nedhorning/TerrapinTracker/Images/switch.png

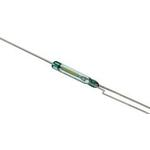
Images/switch.png
