nedhorning/TerrapinTracker/tracker/Hardware/Enclosure/enclosureComparison.jpg

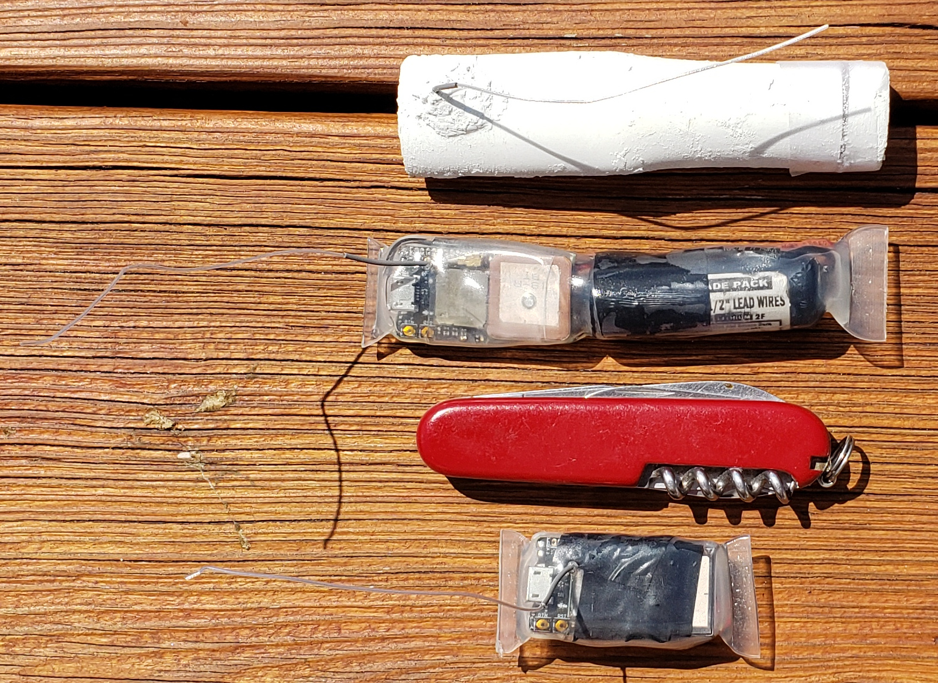
tracker/Hardware/Enclosure/enclosureComparison.jpg
