nedhorning/TerrapinTracker/tracker/Hardware/Enclosure/PVC_EnclosureSideView.jpg

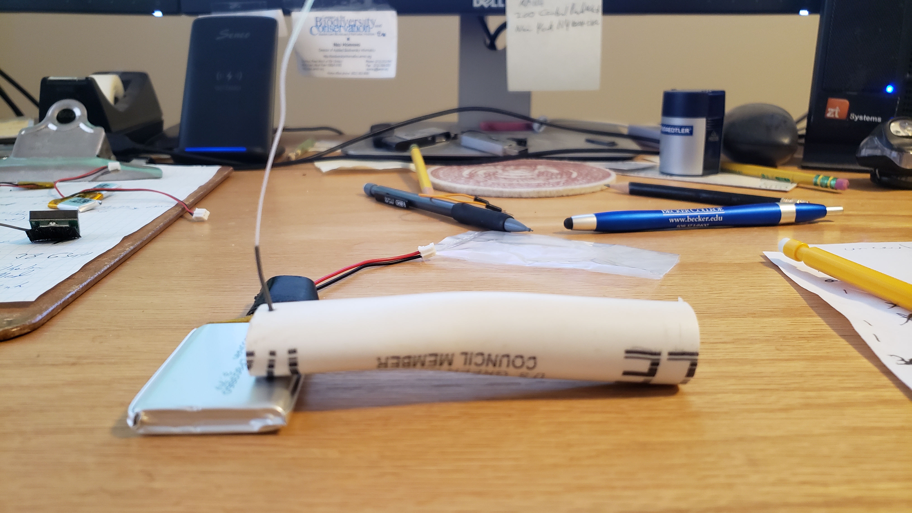
tracker/Hardware/Enclosure/PVC_EnclosureSideView.jpg
