nedhorning/TerrapinTracker/tracker/superceeded/TurtleTracker_TideArray/html/_turtle_tracker___tide_array__tidy_8ino_afe461d27b9c48d5921c00d521181f12f_cgraph.png

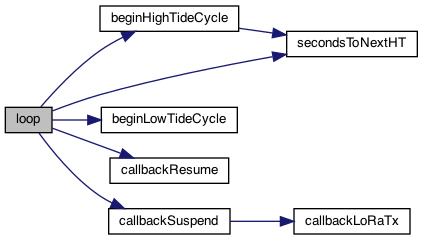
tracker/superceeded/TurtleTracker_TideArray/html/_turtle_tracker___tide_array__tidy_8ino_afe461d27b9c48d5921c00d521181f12f_cgraph.png
