nedhorning/TerrapinTracker/tracker/Hardware/Enclosure/3D_Print/MVIMG_20200927_162711.jpg

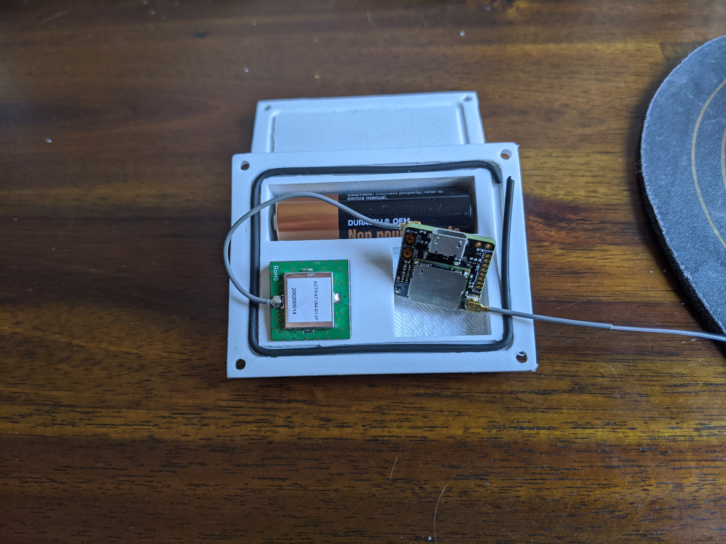
tracker/Hardware/Enclosure/3D_Print/MVIMG_20200927_162711.jpg
