nedhorning/TerrapinTracker/(threads)

Thread 2 (2020-10-07):

Implement the watchdog timer

joshctaylor, 2020-10-07:
The watchdog timing will do a hard reboot if the software locks up

nedhorning, 2021-01-21:
I'll need help with this.

joshctaylor, 2021-02-18:
> I'll need help with this.

I just uploaded a demo for you - slowly getting around to the other bits :)

nedhorning, 2021-02-20:
I noticed that the counter increments by 2 when a reset happens and can't figure out why since it's set in the setup. .

joshctaylor, 2021-02-22:
I have to admit, I tested the reset counter before adding it to the watchdog example. I'll get some time later this week to look.

joshctaylor, 2021-03-01:
Hi @nedhorning I can't recreate this error - its counting correctly for me and tested up to 45 cycles and counting.  Did you use the tool to initialise the EPROM to zero?

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

nedhorning, 2021-03-01:
I didn't initialize the EPROM to zero. Should I do that? I wasn't sure which tool you refer to. I can set all registers to zero but not sure how else to initialize it.

joshctaylor, 2021-03-04:
Moving from emails back to this thread - yes it looks as though this could be the terminal app (I'm using the one built into Arduino on mac) or the serial driver on the PC taking its time. Does adding a delay of a few seconds before the startup message solve the issue?

nedhorning, 2021-03-04:
I tried setting delays at different places and also move Serial.begin and associated while loop to the top of the setup() but the sporadic reset messages persisted. I have a feeling there is an issue reestablishing the serial connection after a restart although not sure why that would be and especially why it would be sporadic. If I can get some time this weekend I'll add the watchdog timer to the tracker code and will try to monitor it via the LoRa packet. I'll add the STM chip temperature as well.

Thread 3 (2020-10-07):

Implement an FIFO disk buffer

joshctaylor, 2020-10-07:
An idea - Write data to flash before sending over LoRa - this should reduce data loss as it will still be there when the device restarts.

joshctaylor, 2021-01-21:
The flash storage on the GNAT has a lifetime of 1000 writes. Use of a flash based FIFO or ring-buffer would require external storage.
https://www.st.com/resource/en/datasheet/stm32f030rc.pdf

Recommend to consider a ring buffer in RAM to store GPS / sensor measurements when LoRaWAN is unavailable

Closed 2021-01-21.

Thread 6 (2021-01-21):

Feature - Power up message

joshctaylor, 2021-01-21:
It would be useful to have a status message each time the tracker power-cycles.

Device ID, battery state, time between power up and first GPS, checksum

nedhorning, 2021-01-21:
I'm trying to get my head around the utility of this. If this was implemented it would need to be relayed via LoRa in order for it to be recorded. Currently, the device ID, battery voltage, and time to get a coordinate fix are reported. Perhaps simply adding a "reboot" flag would be sufficient. I have a boolean variable that reports if coordinates are fresh or if the GNSS receiver was unable to get a coordinate fix. I could convert that to a byte value to add a "restart" condition and that wouldn't add additional size to the LoRa payload. Does that seem to be sufficient?

joshctaylor, 2021-01-22:
I was thinking along the lines of tracking the firmware version and logging errors so it's possible to debug issues once deployed.

I've used a second database for this and used a separate topic on MQTT messages - would something similar be possible with ChirpStack?

nedhorning, 2021-01-22:
I think we should talk about this. I'm having a hard time understanding the utility of this. Once a tracker is deployed the firmware wouldn't change and I'm not sure what errors we could log. I'm already logging success (or not) for coordinate fixes and LoRa reception metadata is part of the data packet. I have a feeling I'm missing something.

I'm pretty sure setting up a separate MQTT topic is possible but not sure how easy it would be. It's possible that it's as simple as editing the configuration file but it's also possible that it would require ChirpStack source code changes.

joshctaylor, 2021-02-05:
I was thinking from the point of view of managing an open source project. Assuming the github code will evolve, people will build devices and download the code at different points in the continued development. We don't know when the code will downloaded or if people will upgrade the device between first set up and deployment.

joshctaylor, 2021-03-04:
Just sorting through open tickets - I implemented an example start up message into the watchdog timer demo. It's in tracker/tools/watchdogExample for field deployment it would be useful to be sent over LoRa and logged.

Thread 7 (2021-01-21):

Feature: Logging

joshctaylor, 2021-01-21:
It may be useful to have a logging feature as a failsafe - this would make it useful for land-based applications when the tracker can be recovered.

nedhorning, 2021-01-21:
The current tracker doesn't have enough memory for significant data storage so this would have to be a version 2 feature. I have mixed feelings about adding logging capabilities. It would be nice for a backup but if for some reason we lose LoRa contact with a tracker it would be very difficult to retrieve that tracker unless there was a traditional UHF/VHF tracker attached to the turtle in addition to the GNSS/LoRa tracker.
