nedhorning/TerrapinTracker/tracker/TurtleTracker_TideArrayNumSatsDownstreamComm/TurtleTracker_TideArrayNumSatsDownstreamComm.ino

/* this file is documented using doxygen*/
#include <STM32L0.h>
#include "LoRaWAN.h"
#include "TimerMillis.h"
#include "GNSS.h"
#include <RTC.h>

/// lora/chirp stack
const char *appEui = "70B3D57ED0029388";
const char *appKey = "9C5E64056A46C2872DED008E20A6F95A";  // This is set using the ChirpStack Application Server 
const char *devEui = "3934353776377f0b";  
uint32_t UID[3] = {0, 0, 0};

bool initialized = false;  // Flag set when GNSS get initial fix and sets RTC

/// GNSS/GPS variables
GNSSLocation myLocation;  // create object
GNSSSatellites mySatellites;  // create object
uint8_t withSignalCount = 0;
uint8_t minWithSignalCount = 1; // Minimum number of satellites to receive signal within maxSignalSearchTime 
uint8_t minSNR = 10; // Minimum signal to noise ratio to qualify as a received signal
uint32_t maxSignalSearchTime = 5000; // Milliseconds to receive a signal from minWithSignalCount number of satellites 
volatile bool recvSats = false;
volatile bool isTracking = true;
uint8_t freshGPS = 0;
uint16_t fixType = 0;
uint32_t startTimeToFix = 0;  
int16_t timeToFix = 0;
int32_t latOut, longOut;
float Long, Lat, Alt, EPE;
int32_t latInt, longInt, altInt;
int16_t EPE_Int, vbatInt; 
byte latArray[4], longArray[4], altArray[4], EPE_Array[2], timeToFixArray[2], timeArray[4], vbatArray[2];

/// Define the tide arraay in program memory
const PROGMEM uint32_t HT_Times[] = {1577856000,1577899740,1577945520,1577989080,1578035100,1578078720,1578124740,1578168480,1578214260,1578258180,1578303600,1578347760,1578392760,1578437160,1578481860,1578526440,1578570900,1578615600,1578659940,1578704820,1578749040,1578793980,1578838200,1578883320,1578927420,1578972780,1579016820,1579062420,1579106400,1579152300,1579196220,1579242420,1579286400,1579332720,1579376760,1579422960,1579467240,1579512960,1579557480,1579602720,1579647300,1579692180,1579736820,1579781400,1579826040,1579870380,1579915020,1579959240,1580003880,1580047980,1580092620,1580136660,1580181360,1580225280,1580270040,1580313960,1580358840,1580402700,1580447760,1580491620,1580536920,1580580840,1580626500,1580670600,1580716320,1580760780,1580806260,1580850960,1580896020,1580940900,1580985600,1581030540,1581075060,1581119940,1581164340,1581209220,1581253620,1581298560,1581342840,1581387840,1581432120,1581477240,1581521460,1581566760,1581610980,1581656460,1581700680,1581746460,1581790740,1581836700,1581881280,1581927120,1581971940,1582017420,1582062360,1582107360,1582152300,1582196880,1582241700,1582286040,1582330680,1582374900,1582419480,1582463580,1582508100,1582552140,1582596600,1582640640,1582685040,1582729140,1582773480,1582817580,1582861920,1582906080,1582950480,1582994700,1583039280,1583083680,1583128620,1583173260,1583218560,1583263680,1583308980,1583354460,1583399400,1583444820,1583489460,1583534700,1583579160,1583624220,1583668620,1583713620,1583758020,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
uint8_t highTideRefMonth = 1; // January = 1 and December = 12
uint8_t highTideRefDay = 1;  // Day
uint8_t highTideRefHour = 0;  // Hour in 24 hour clock
uint8_t highTideRefMinute = 20;  // Minutes
uint8_t highTideRefSecond = 0;  // Seconds
uint32_t timeRTC; 

/// Define high tide timing variables
TimerMillis myTimerResume;  ///< timer object for alarm
bool isHighTide = false;
uint8_t isHighTideByte;
uint32_t refHighTide;  ///< Number of second from beginning of year to reference high tide 
uint32_t millisNextHighTide;
int16_t secBeforeHTStart; ///< Seconds before starting high tide cycles
uint32_t durationHighFrequency = (minutesBeforeHighTide + minutesAfterHighTide) * 60 * 1000; ///< Duration of high frequency GPS looging in milliseconds
uint32_t startHT_Time = 0; ///< Time high tide monitoring cycle starts
 
/// Pin Assignments
#define pps          4     ///< 1 Hz  MAX M8Q GNSS fix pulse
#define myBat    A1 ///< LiPo battery ADC
#define myBat_en  2 ///< LiPo battery monitor enable

/// initalise battery monitoring variables
float VDDA, VBAT;

void setup()
{  
  /// setup coms
  Serial.begin(115200);
  delay(4000);

  /// Configuree LoRaWAN connection
  STM32L0.getUID(UID);  ///< Get LoRa/LoRaWAN ID for SX1276
  LoRaWAN.begin(US915);  ///< select frequency plan
  LoRaWAN.setADR(false);  ///< automatic data rate
  LoRaWAN.setDataRate(1);  ///< select data rate
  LoRaWAN.setTxPower(20);   ///< transmit power
  LoRaWAN.setSubBand(2); ///< 1 for MTCAP, 2 for TT gateways
  LoRaWAN.joinOTAA(appEui, appKey, devEui);  ///< use Over The Air Authorization (OTAA)
  LoRaWAN.onReceive(receiveCallback);   ///< enable downstream communications to modify variables

  /// configure IO pins 
  pinMode(myBat_en, OUTPUT);  ///< set voltage probe pin as output
  pinMode(myBat, INPUT);    ///< set up ADC battery voltage monitor pin
  digitalWrite(myBat_en, LOW);
  analogReadResolution(12); ///< 12 = 12-bit ADC resolution
  pinMode(pps, INPUT); ///< select pps as input from MAX M8Q

  /* Set RTC time and date based on reference tide */
  RTC.setHours(highTideRefHour);
  RTC.setMinutes(highTideRefMinute);
  RTC.setSeconds(highTideRefSecond);
  RTC.setDay(highTideRefDay);
  RTC.setMonth(highTideRefMonth);
  RTC.setYear(highTideRefYear-2000);
  refHighTide = RTC.getEpoch();

   /* Initialize and configure GNSS */
  GNSS.begin(Serial1, GNSS.MODE_UBLOX, GNSS.RATE_1HZ); // Start GNSS
  while (GNSS.busy()) { } 

  GNSS.setConstellation(GNSS.CONSTELLATION_GPS_AND_GLONASS); // choose satellite constellations
  GNSS.setConstellation((GNSSClass::GNSSconstellation)11); 
  // 11 = GPS + GLONASS + Galileo  For GPS + Beidou + Galileo use 13
  while (GNSS.busy()) { } 

  GNSS.setAntenna(GNSS.ANTENNA_EXTERNAL);  
  while (GNSS.busy()) { }

  GNSS.enableWakeup();

  // set alarm to update the RTC periodically
  RTC.setAlarmTime(0, 0, 0);
  RTC.enableAlarm(RTC.MATCH_SS); // alarm once a minute
  RTC.attachInterrupt(alarmMatch);


}

void loop()
{
  /*GNSS*/

  if(GNSS.location(myLocation))
 
  {
    if (recvSats == false && GNSS.satellites(mySatellites))
    {
      withSignalCount = 0;
      for (unsigned int index = 0; index < mySatellites.count(); index++)
      {
        if (mySatellites.snr(index) > minSNR)
        {
          withSignalCount++;
        }
      }
      if (withSignalCount >= minWithSignalCount) 
      {
        recvSats = true;
      }
    }
    if ((((millis() - startTimeToFix) > (myAcqTime * 1000)) || (recvSats == false && (millis() - startTimeToFix) > maxSignalSearchTime)) && initialized && isTracking)
    {
      isTracking = false;
      callbackSuspend();
    }
  
    if (myLocation.fixType() != GNSSLocation::TYPE_NONE)
    {      
      if (myLocation.fixType() != GNSSLocation::TYPE_TIME)
      {
        Lat = myLocation.latitude();
        myLocation.latitude(latOut);
        Long = myLocation.longitude();
        myLocation.longitude(longOut);
        Alt = myLocation.altitude();
        EPE = myLocation.ehpe(); // use this as accuracy figure of merit
      
        // Wait until a good fix is acquired 
        if( (myLocation.fixType() != GNSSLocation::TYPE_2D) && (EPE <= maxEPE) && myLocation.fullyResolved()) 
        {  
          /* Reset RTC time and date based on GPS */
          RTC.setHours(myLocation.hours());
          RTC.setMinutes(myLocation.minutes());
          RTC.setSeconds(myLocation.seconds());
          RTC.setDay(myLocation.day());
          RTC.setMonth(myLocation.month());
          RTC.setYear(myLocation.year()- 2000);
           
          if (!initialized) 
          {
            maxEPE = longTermEPE;
            isTracking = false;
            initialized = true;
            freshGPS = 1;
            timeRTC = RTC.getEpoch();
            callbackSuspend();
            myTimerResume.start(callbackResume, 1000, myPeriodLT * 1000);
            secBeforeHTStart = secondsToNextHT(timeRTC, false) - (minutesBeforeHighTide * 60);
            if (secBeforeHTStart <= 0) 
            {
              // If in a HT cycle wait for the next one
              secBeforeHTStart = secondsToNextHT(timeRTC, true) - (minutesBeforeHighTide * 60); 
            }
            millisNextHighTide = millis() + (secBeforeHTStart * 1000);
          } else
          {
            if (isTracking)
            {
              isTracking = false;
              freshGPS = 1;
              timeToFix = round((millis() - startTimeToFix)/1000);  
              timeRTC = RTC.getEpoch();
              callbackSuspend();
            }
          }
        }
      } 
    }   
  } /* end of GNSS Location handling */
   
  if (initialized)
  {
    if (isHighTide)
    {
      if ((millis() - startHT_Time) > durationHighFrequency)
      {
        isHighTide = false;
        beginLowTideCycle();
      }
     } else
     {
       if (millis() > millisNextHighTide)
       {
         isHighTide = true;
         beginHighTideCycle();
       }
    }
  }
  STM32L0.stop();        // Enter STOP mode and wait for an interrupt
}  

void callbackLoRaTx(void)
{     
  if (!LoRaWAN.joined()) 
  {
     LoRaWAN.rejoinOTAA();
  }
  if (!LoRaWAN.busy() && LoRaWAN.joined())
  {
    latInt = round(Lat * 1000000);
    latArray[0] = (latInt & 0xFF000000) >> 24;
    latArray[1] = (latInt & 0x00FF0000) >> 16;
    latArray[2] = (latInt & 0x0000FF00) >> 8;
    latArray[3] = (latInt & 0x000000FF);
    longInt = round(Long * 1000000);
    longArray[0] = (longInt & 0xFF000000) >> 24;
    longArray[1] = (longInt & 0x00FF0000) >> 16;
    longArray[2] = (longInt & 0x0000FF00) >> 8;
    longArray[3] = (longInt & 0x000000FF);
    altInt = round(Alt * 1000000);
    altArray[0] = (altInt & 0xFF000000) >> 24;
    altArray[1] = (altInt & 0x00FF0000) >> 16;
    altArray[2] = (altInt & 0x0000FF00) >> 8;
    altArray[3] = (altInt & 0x000000FF);
    
    EPE_Int = round(EPE * 100);
    EPE_Array[0] = (EPE_Int & 0xFF00) >> 8;
    EPE_Array[1] = (EPE_Int & 0x00FF);
    timeToFixArray[0] = (timeToFix & 0xFF00) >> 8;
    timeToFixArray[1] = (timeToFix & 0x00FF);

    isHighTideByte = isHighTide;
    timeArray[0] = (timeRTC & 0xFF000000) >> 24;
    timeArray[1] = (timeRTC & 0x00FF0000) >> 16;
    timeArray[2] = (timeRTC & 0x0000FF00) >> 8;
    timeArray[3] = (timeRTC & 0x000000FF);
    digitalWrite(myBat_en, HIGH);
    VDDA = STM32L0.getVDDA();
    VBAT = 1.27f * VDDA * ((float) analogRead(myBat)) / 4096.0f;
    digitalWrite(myBat_en, LOW);
    vbatInt = round(VBAT * 1000);
    vbatArray[0] = (vbatInt & 0xFF00) >> 8;
    vbatArray[1] = (vbatInt & 0x00FF);
     
    LoRaWAN.beginPacket();
    LoRaWAN.write(latArray[0]);
    LoRaWAN.write(latArray[1]);
    LoRaWAN.write(latArray[2]);
    LoRaWAN.write(latArray[3]);
    LoRaWAN.write(longArray[0]);
    LoRaWAN.write(longArray[1]);
    LoRaWAN.write(longArray[2]);
    LoRaWAN.write(longArray[3]);
    LoRaWAN.write(altArray[0]);
    LoRaWAN.write(altArray[1]);
    LoRaWAN.write(altArray[2]);
    LoRaWAN.write(altArray[3]);
    LoRaWAN.write(EPE_Array[0]);
    LoRaWAN.write(EPE_Array[1]);
    LoRaWAN.write(timeToFixArray[0]);
    LoRaWAN.write(timeToFixArray[1]);
    LoRaWAN.write(freshGPS);
    LoRaWAN.write(isHighTide);
    LoRaWAN.write(timeArray[0]);
    LoRaWAN.write(timeArray[1]);
    LoRaWAN.write(timeArray[2]);
    LoRaWAN.write(timeArray[3]);
    LoRaWAN.write(vbatArray[0]);
    LoRaWAN.write(vbatArray[1]);
    LoRaWAN.endPacket();
  }    
}

void callbackSuspend(void)
{
  GNSS.suspend();
  timeToFix = round((millis() - startTimeToFix)/1000);  // Also time to give up getting a fix when freshGPS = 0
  callbackLoRaTx();  
  freshGPS = 0;
  recvSats = false;
}

void callbackResume(void)
{
  GNSS.resume();
  recvSats = false;
  startTimeToFix = millis();
  //mySatellites = GNSSSatellites(); //ResetGNSSSatellites class
  isTracking = true; 
}

void beginHighTideCycle(void) // Start the high tide cycle
{
  myTimerResume.restart(1000, (myPeriodHT * 1000));
  startHT_Time = millis();
  timeRTC = RTC.getEpoch();
  secBeforeHTStart = secondsToNextHT((timeRTC), true) - (minutesBeforeHighTide * 60);
  millisNextHighTide = millis() + (secBeforeHTStart * 1000);
}

void beginLowTideCycle(void) // Start the low tide cycle
{
  myTimerResume.restart(1000, myPeriodLT * 1000);
}

void alarmMatch()
{
  STM32L0.wakeup();
}

uint32_t secondsToNextHT(uint32_t time, boolean getNextIndex)
{
  int i = 0;
  uint32_t seconds;
  while (HT_Times[i] < time) 
  {
      i++;
  }
  if (getNextIndex) i++;
  seconds = HT_Times[i] - time; 
  return seconds;
}

void receiveCallback(void)
{
  if (LoRaWAN.parsePacket())
  {
    uint32_t size;
    uint8_t data[256];

    size = LoRaWAN.read(&data[0], sizeof(data));

    if (size)
    {
      data[size] = '\0';
      switch(LoRaWAN.remotePort()) 
      {
        case 1:
          maxEPE = (uint16_t)strtoul((const char*)&data[0], NULL, 10);
          break;
        case 2:
          myAcqTime = (uint32_t)strtoul((const char*)&data[0], NULL, 10);
          break;
        case 3:
          myPeriodHT = (uint32_t)strtoul((const char*)&data[0], NULL, 10);
          myTimerResume.restart(1000, (myPeriodHT * 1000));
          break;
        case 4:
          myPeriodLT = (uint32_t)strtoul((const char*)&data[0], NULL, 10);
          myTimerResume.restart(1000, myPeriodLT * 1000);
          break;
        case 5:
          minutesBeforeHighTide = (uint32_t)strtoul((const char*)&data[0], NULL, 10);
          durationHighFrequency = (minutesBeforeHighTide + minutesAfterHighTide) * 60 * 1000;
          break;
        case 6:
          minutesAfterHighTide = (uint32_t)strtoul((const char*)&data[0], NULL, 10);
          durationHighFrequency = (minutesBeforeHighTide + minutesAfterHighTide) * 60 * 1000;
          break;
        case 7:
          minWithSignalCount = (uint8_t)strtoul((const char*)&data[0], NULL, 10);
          break;
        case 8:
          minSNR = (uint8_t)strtoul((const char*)&data[0], NULL, 10);
          break;
        case 9:
          maxSignalSearchTime = (uint32_t)strtoul((const char*)&data[0], NULL, 10);
          break;
      }
    }
  }
}
