nedhorning/TerrapinTracker/(commit log)

2020-04-16 Noted current difference with GNSS antennas
2020-07-01 Added guide and enclosure photo
2020-07-17 Added battery voltage monitoring script
2020-07-17 Updated decode guide to add battery monitoring field
2020-08-26 Updated enclosure directory
2020-09-10 Added product requirement description justfication spreadsheet
    [TerrapinTracker_PRD_v3.xlsx]
2020-09-11 Updated GNSS antenna test document
2020-09-18 Added enclosure video
2020-09-18 Added heat shrink enclosure image
2020-09-28 Added 3D enclosure images
2021-01-21 rearrage repository and combine readme files
    In addition to re-organisation we did together I have combined a couple of the readme files.
2021-01-22 Added Doxygen markup to arduino sketch
2021-02-18 demonstration of watchdog timer
2021-02-19 added power cycle counter and hardware version in eeprom
2021-02-24 Noted that the SAFT battery is being replaced
    [TurtleTracker_TideArray.ino, TurtleTracker_TideArrayNumSatsDownstreamComm.ino, watchdogExample.ino]
2021-03-03 moved sketch to reset power cycle counter
    [initaliseResetCounter.ino]
