nedhorning/TerrapinTracker/tracker/Hardware/Enclosure/3D_Print/IMG_20200927_163140.jpg

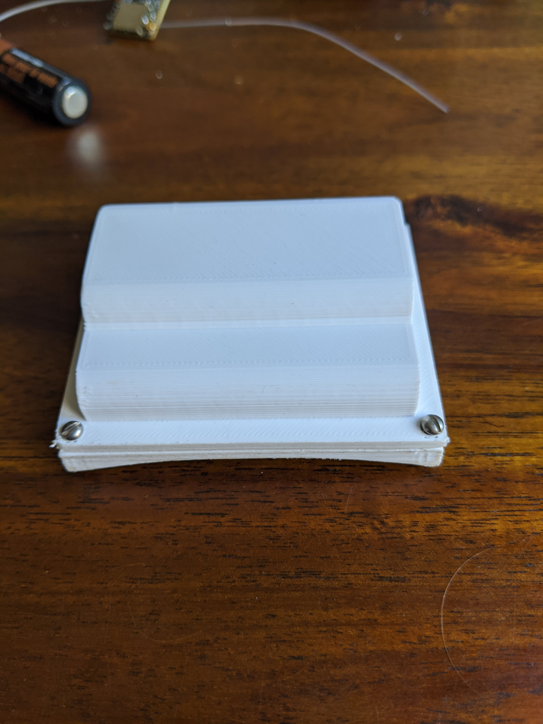
tracker/Hardware/Enclosure/3D_Print/IMG_20200927_163140.jpg
